AntwangXD/dds_hat/dds_article/dds_installed.png

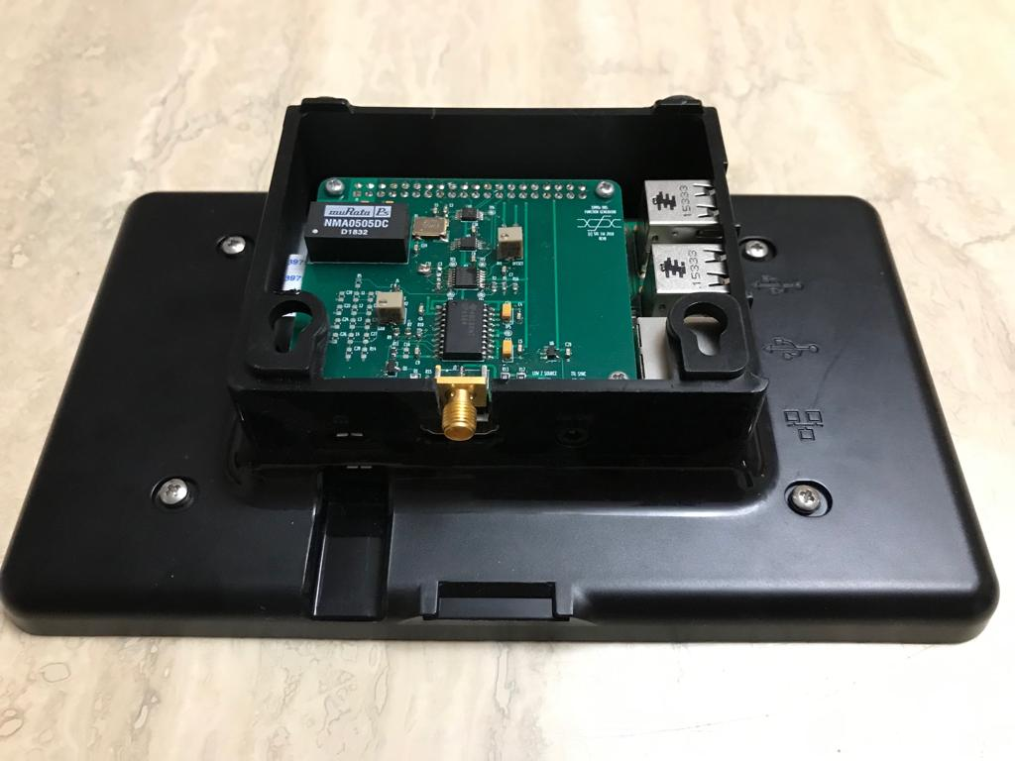
dds_article/dds_installed.png
