AntwangXD/dds_hat/dds_article/complete_instrument.png

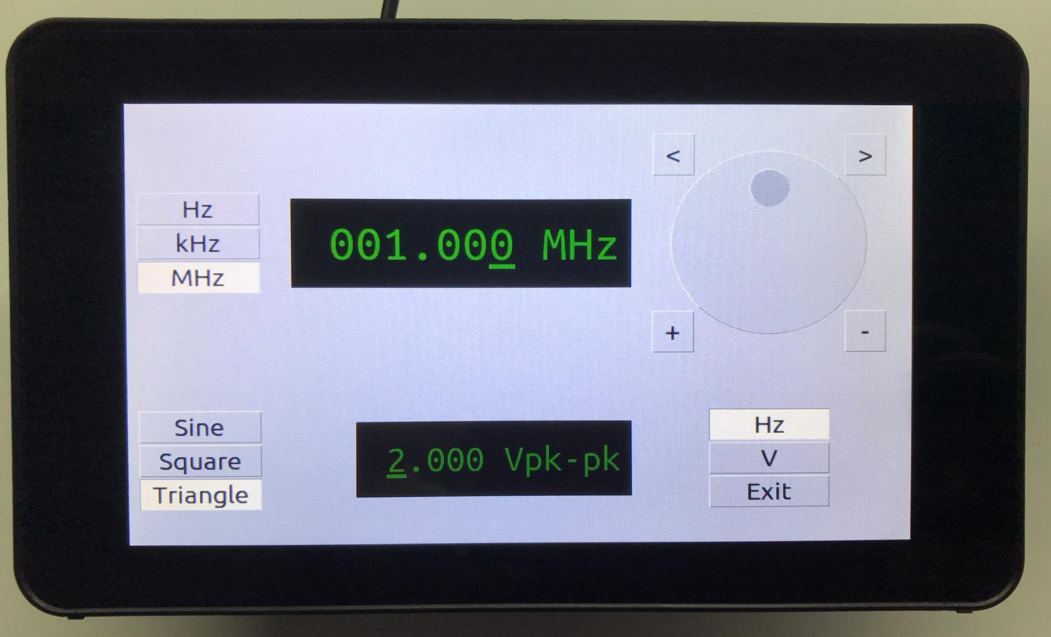
dds_article/complete_instrument.png
