AntwangXD/dds_hat/dds_article/LNM_Author_Contract_100-1.pdf

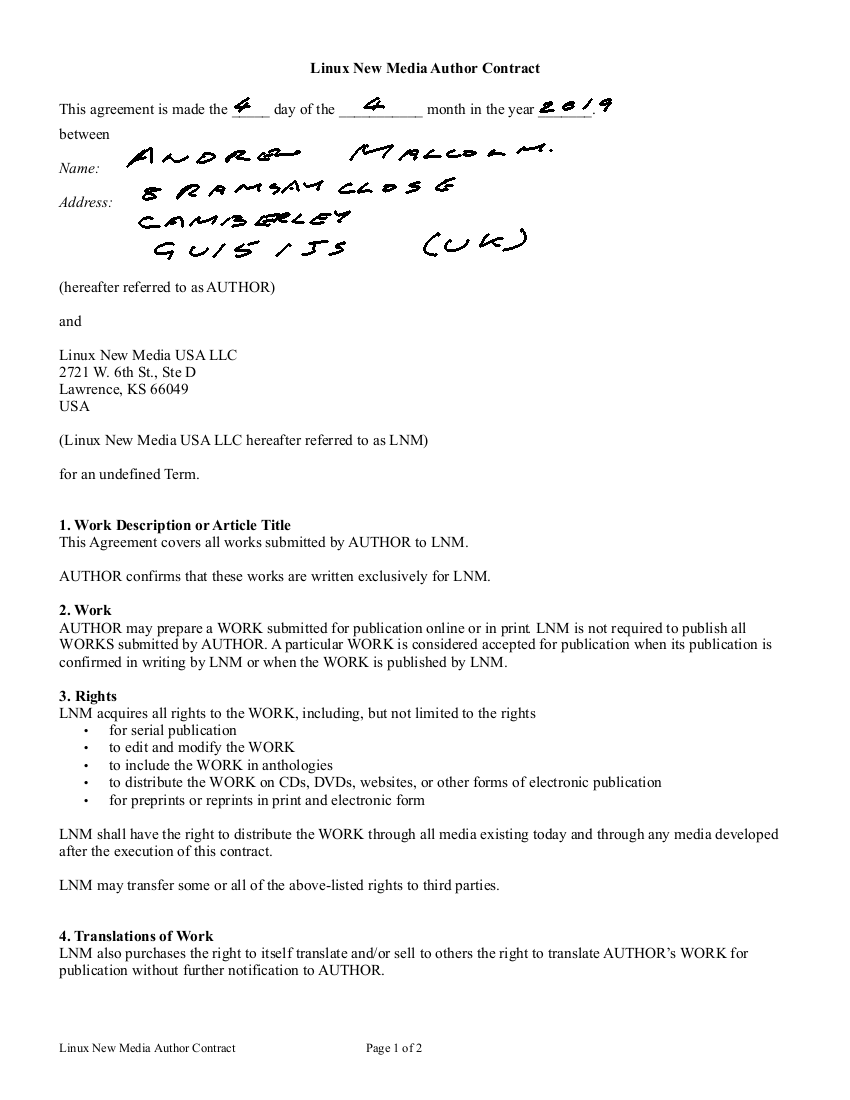
[picture p3: page 1]
