AntwangXD/dds_hat/dds_article/LNM_Author_Contract_100.pdf

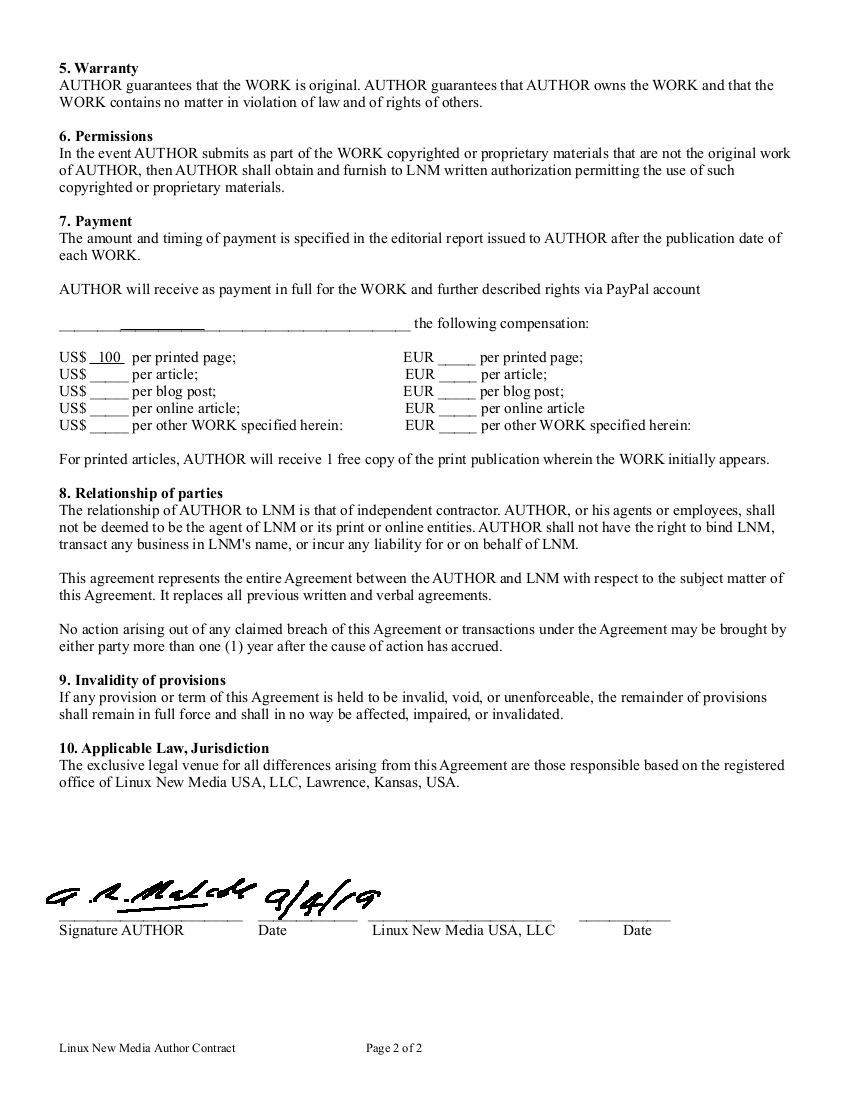
[picture p4: page 1]
