AntwangXD/dds_hat/dds_article/dds_gui.png

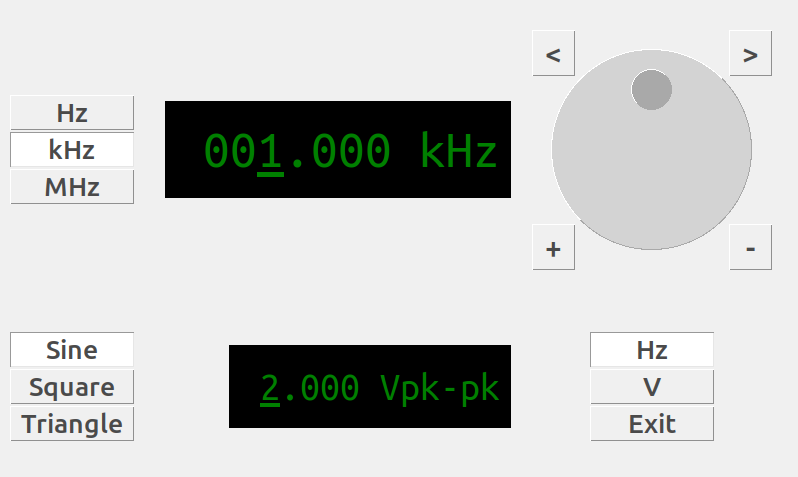
dds_article/dds_gui.png
