AntwangXD/dds_hat/dds_article/dds_render.png

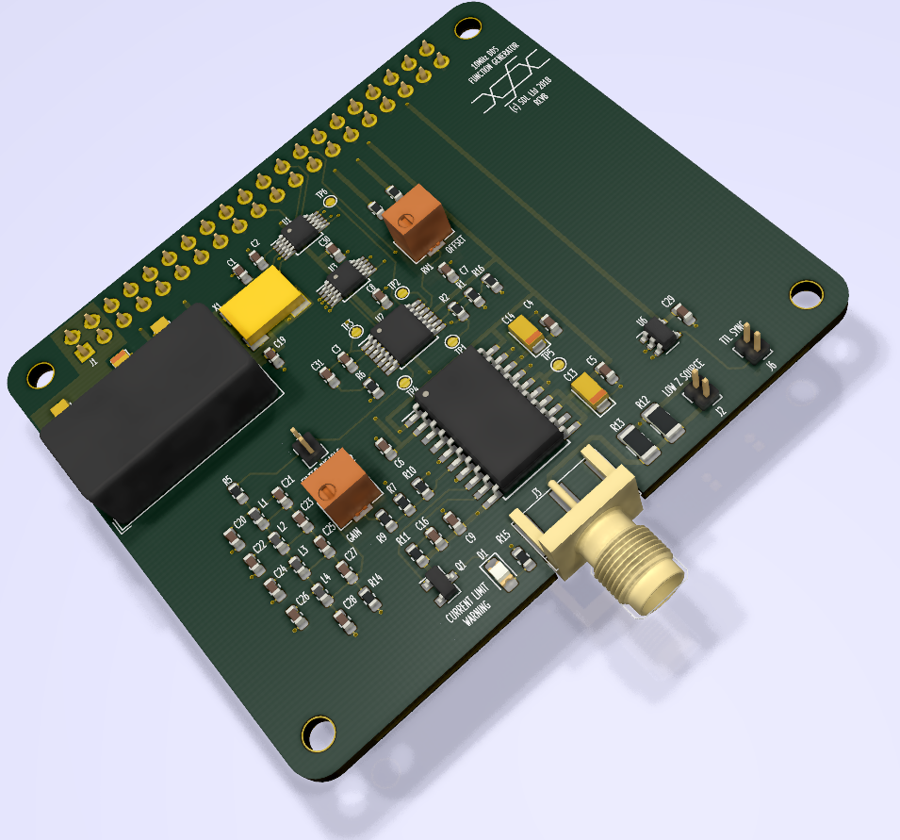
dds_article/dds_render.png
