AntwangXD/dds_hat/REVB/documents/filter-circuit.png

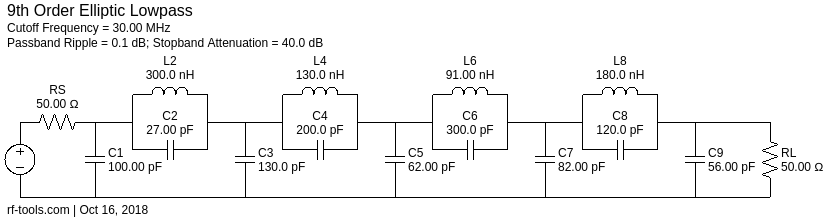
REVB/documents/filter-circuit.png
