AntwangXD/dds_hat/REVB/documents/filter-design.png

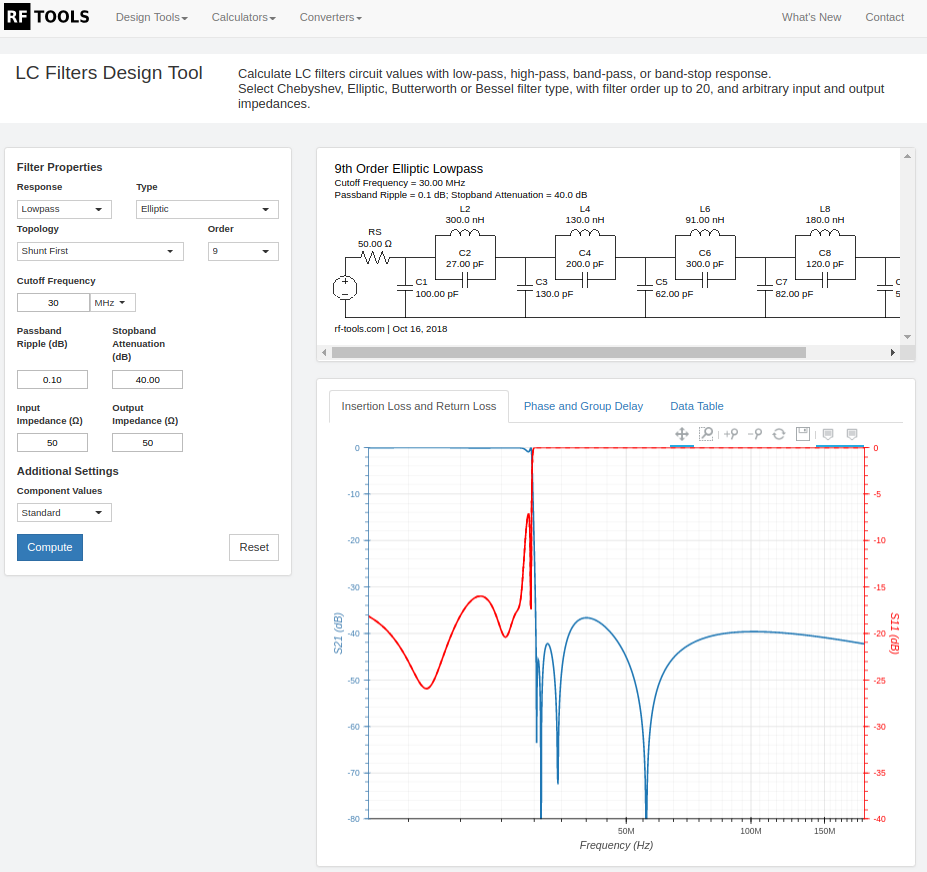
REVB/documents/filter-design.png
