AntwangXD/dds_hat/REVB/DDS-hat.ods

Id | Designator | Package | Quantity | Designation | Supplier and ref | Farnell p/n |  | Pack size
1 | J2,J5,J6 | PinHeader_1x02_P1.27mm_Vertical | 3 | Conn_01x02 |  |  |  |  | 0
2 | U4 | Converter_DCDC_muRata_NMAxxxxDC_THT | 1 | NMA0505DC |  | 1021427 | 6.86 |  | 6.86 | x | rs
3 | C31,C30,C29,C19,C10,C4,C5,C7,C8,C9,C11,C18,C6,C1 | C_0603_1608Metric | 14 | 100n |  |  |  |  | 0 | x
4 | J3 | SMA_EdgeMount | 1 | Cinch 142-0701-801 |  |  | 2.83 |  | 2.83 | x | stock
5 | U5 | HSOP-20_PowerPAD | 1 | OPA564AIDWP |  | 2782821 | 5.34 |  | 5.34 | x | post
6 | R16,R10,R7,R3,R4,R1 | R_0603_1608Metric | 6 | 1K |  |  |  |  | 0 | x
7 | U6 | TSOP-5_1.65x3.05mm_P0.95mm | 1 | 74AHC1G04GW5-7 |  | 1085239 | 0.16 | 5 | 0.16 | x | stock
8 | D1 | LED_LH_R974 | 1 | LH R974 |  | 1465992 | 0.21 |  | 0.21 | x
9 | Q1 | SOT-23 | 1 | BST82 |  | 1081313 | 0.1 |  | 0.1 | x | rs
10 | R15 | R_0603_1608Metric | 1 | 330R |  |  |  |  | 0 | x | rs
11 | C28 | C_0603_1608Metric | 1 | 56p |  |  |  |  | 0
12 | C27 | C_0603_1608Metric | 1 | 120p |  |  |  |  | 0
13 | C26,C24,C22 | C_0603_1608Metric | 3 | 75p |  |  |  |  | 0
14 | C25 | C_0603_1608Metric | 1 | 300p |  |  |  |  | 0
15 | C23 | C_0603_1608Metric | 1 | 200p |  |  |  |  | 0
16 | C21 | C_0603_1608Metric | 1 | 27p |  |  |  |  | 0
17 | C20 | C_0603_1608Metric | 1 | 100p |  |  |  |  | 0
18 | L3 | L_0603_1608Metric | 1 | 91n |  | 2448213 | 0.05 | 10 | 0.05
19 | L1 | L_0603_1608Metric | 1 | 330n |  | 2448216 | 0.09 | 10 | 0.09
20 | L4 | L_0603_1608Metric | 1 | 180n |  | 1457844 | 0.12 | 10 | 0.12
21 | L2 | L_0603_1608Metric | 1 | 120n |  | 2448215 | 0.06 | 10 | 0.06
22 | R5,R14 | R_0603_1608Metric | 2 | 50R |  |  |  |  | 0
23 | C14,C17,C15,C13,C12 | CP_EIA-3216-10_Kemet-I | 5 | 10u |  |  |  |  | 0
25 | RV2,RV1 | Potentiometer_Bourns_3214W_Vertical | 2 | 200R |  | 1612571 | 3.84 |  | 7.68 | x | existing
26 | X1 | MCSJK-6NC1-25.00-25-B | 1 | 25MHz |  | 2854377 | 0.66 |  | 0.66 | x | rs
27 | C16 | C_0603_1608Metric | 1 | 1n |  |  |  |  | 0 | x
28 | J1 | PinSocket_2x20_P2.54mm_Vertical | 1 | BCS-120-F-D-TE |  | 2308433 | 5.2 |  | 5.2 | x | sample
29 | U3 | MSOP-10_3x3mm_P0.5mm | 1 | AD5443YRMZ |  | 1581921 | 5.26 |  | 5.26 | x
30 | U2 | TSSOP-14_4.4x5mm_P0.65mm | 1 | OPA4354AIPW |  | 2112580 | 3.16 |  | 3.16
31 | R11,R6 | R_0603_1608Metric | 2 | 200K |  |  |  |  | 0
32 | R12,R13 | R_1206_3216Metric | 2 | 100R 400mW |  | 2008392 | 0.04 | 10 | 0.08 | x
33 | R9 | R_0603_1608Metric | 1 | 1K8 |  |  |  |  | 0
34 | R2 | R_0603_1608Metric | 1 | 6K8 |  |  |  |  | 0
35 | C3 | C_0603_1608Metric | 1 | 1p |  |  |  |  | 0
36 | C2 | C_0603_1608Metric | 1 | 10n |  |  |  |  | 0
37 | U1 | MSOP-10_3x3mm_P0.5mm | 1 | AD9833BRMZ |  | 1581966 | 7.4 |  | 7.4 |  | existing
 |  |  |  |  |  |  |  |  | 45.26
