AntwangXD/dds_hat/REVB/3214w-1-201e.stp

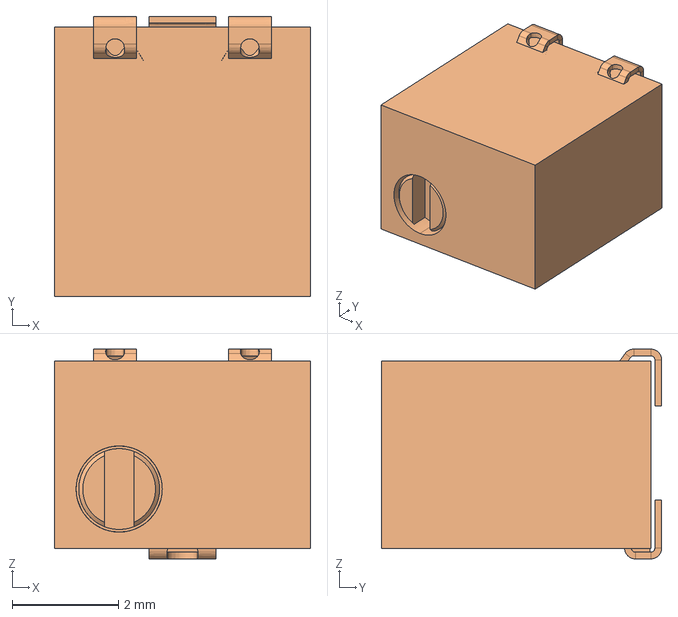
[picture p9: CAD file, 2019-06-15]
REVB/3214w-1-201e.stp
4.83 x 5.28 x 3.96 mm
