AntwangXD/dds_hat/REVB/3D models/SMD-XTAL.step

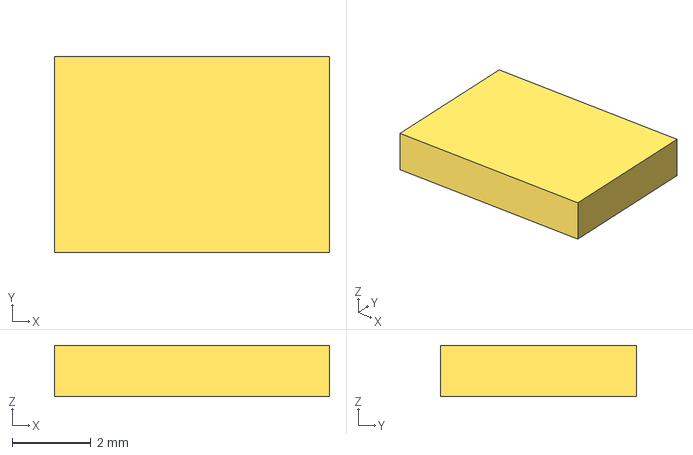
[picture p10: CAD file, 2019-06-15]
REVB/3D models/SMD-XTAL.step
7.00 x 5.00 x 1.30 mm
