AntwangXD/dds_hat/REVB/3D models/SMA-J-P-H-ST-EM1.stp

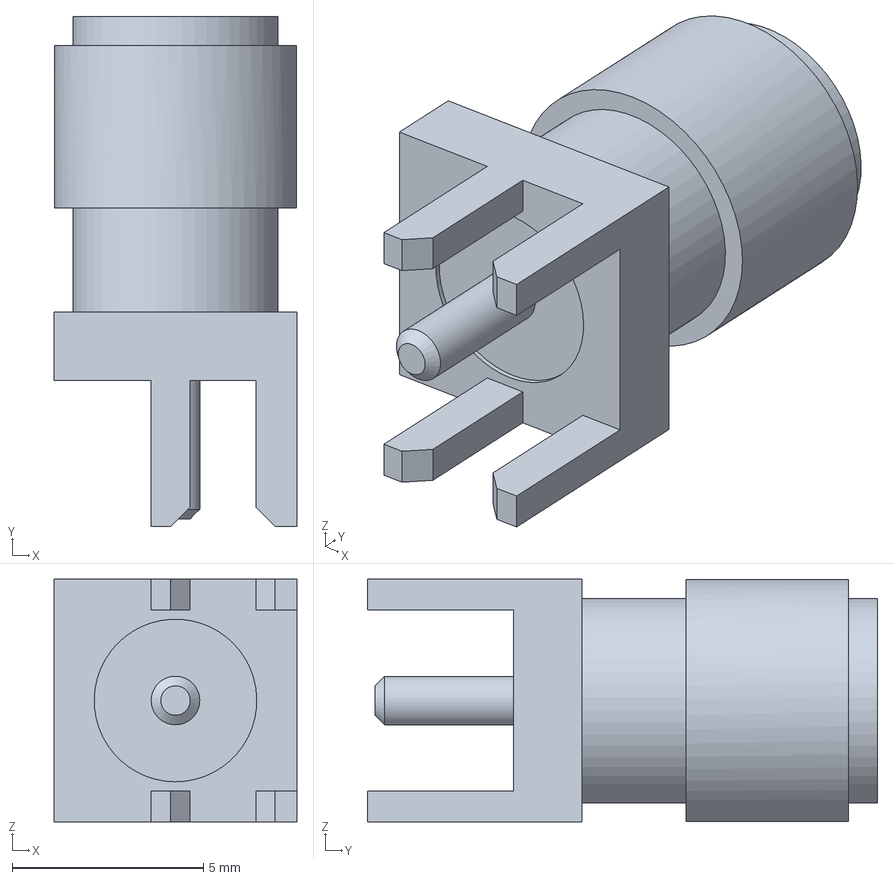
[picture p11: CAD file, 2019-06-15]
REVB/3D models/SMA-J-P-H-ST-EM1.stp
6.35 x 13.3 x 6.35 mm
