AntwangXD/dds_hat/REVB/3D models/142-0701-801.step

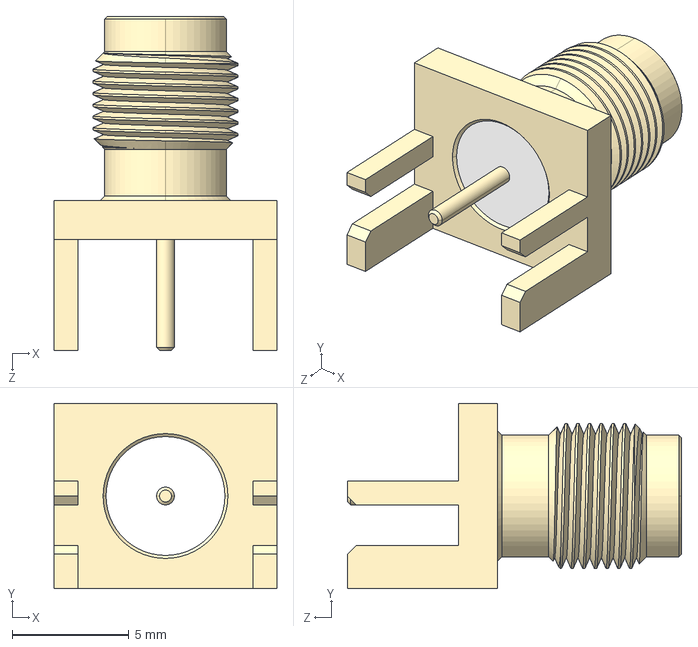
[picture p12: CAD file, 2019-06-15]
REVB/3D models/142-0701-801.step
9.52 x 7.92 x 14.3 mm
