AntwangXD/dds_hat/(list of files, cad)

Other CAD files:
REVA/3D models/SMD-XTAL.fcstd
REVB/3D models/SMD-XTAL.fcstd
