AntwangXD/dds_hat/dds_article/dds_schematic.pdf

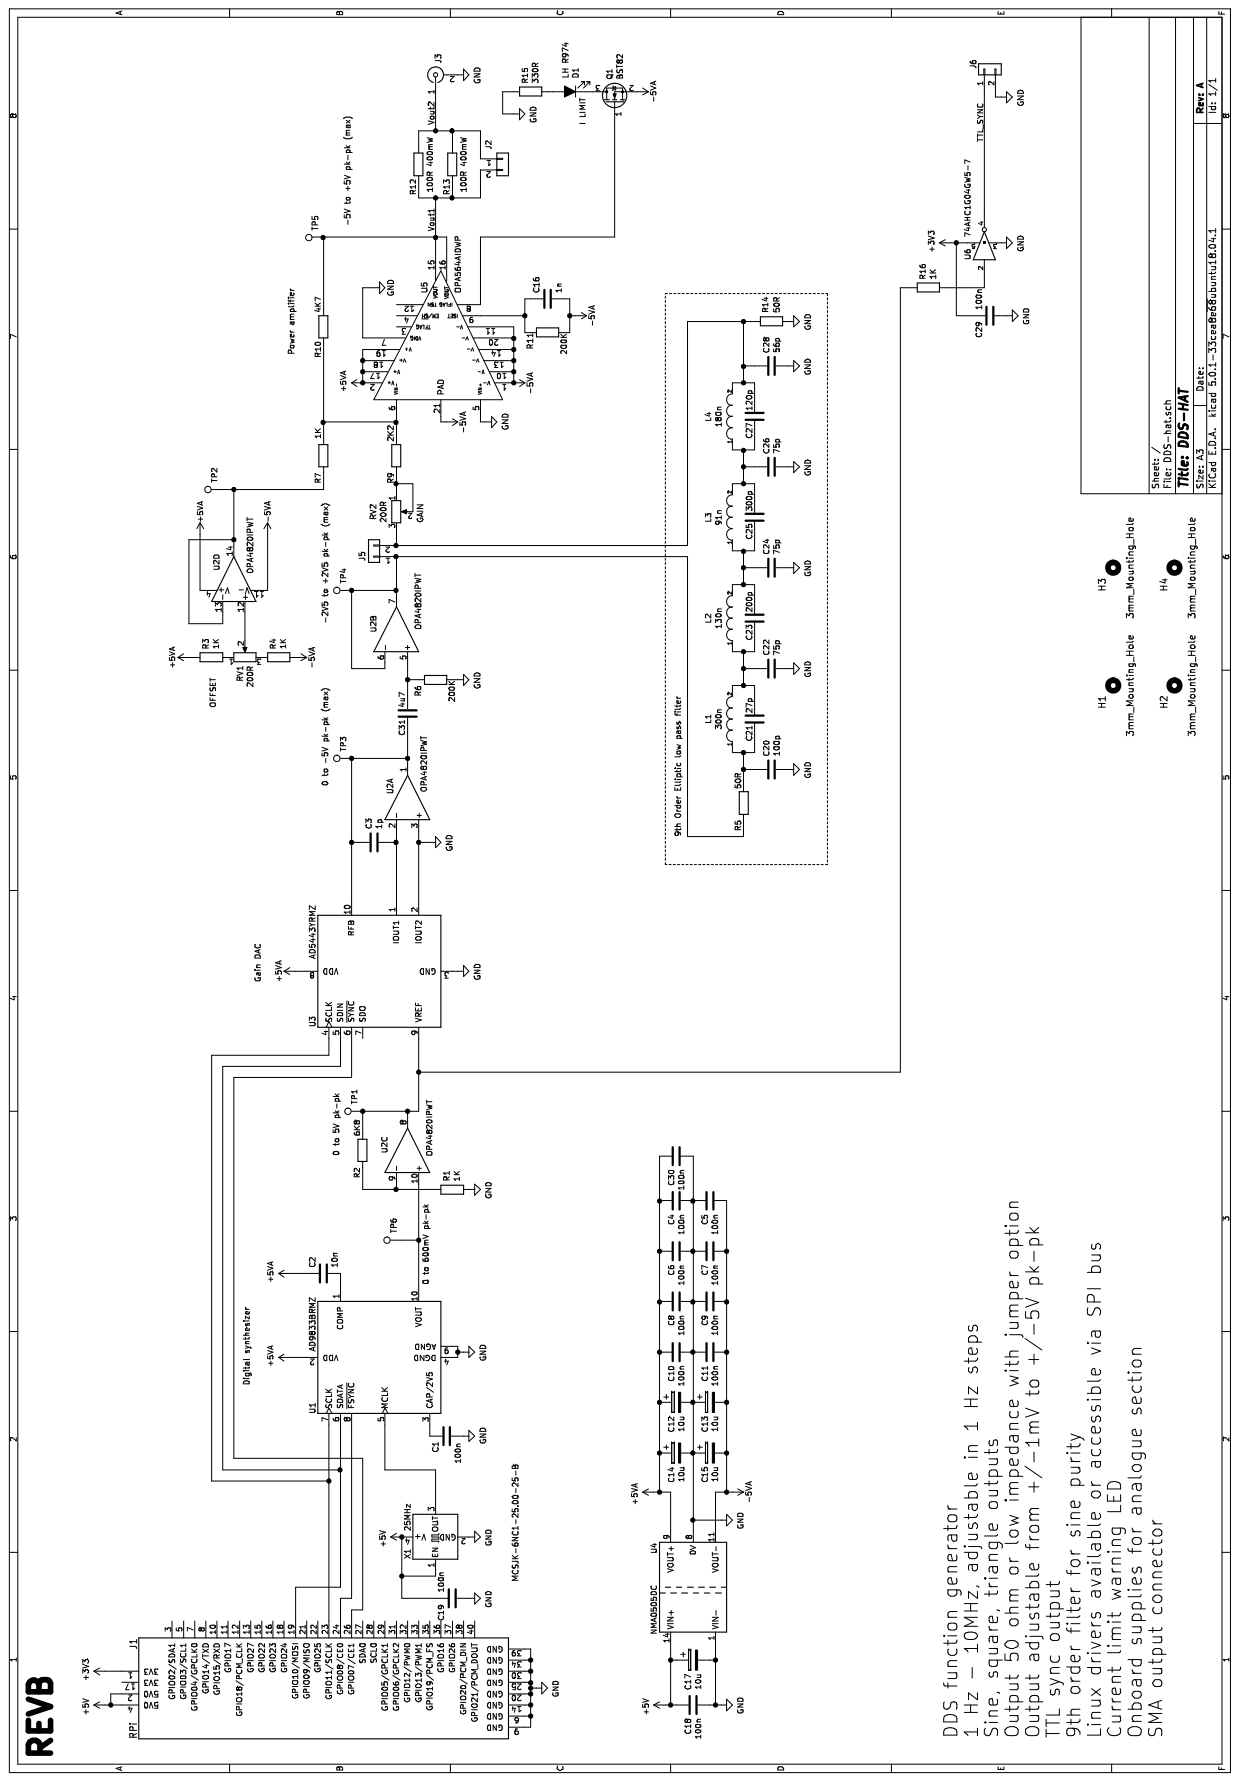
[picture p13: page 1]
