AntwangXD/dds_hat/REVB/DDS-hat.kicad_pcb

## KiCad design REVB/DDS-hat.kicad_pcb (2019-06-15)

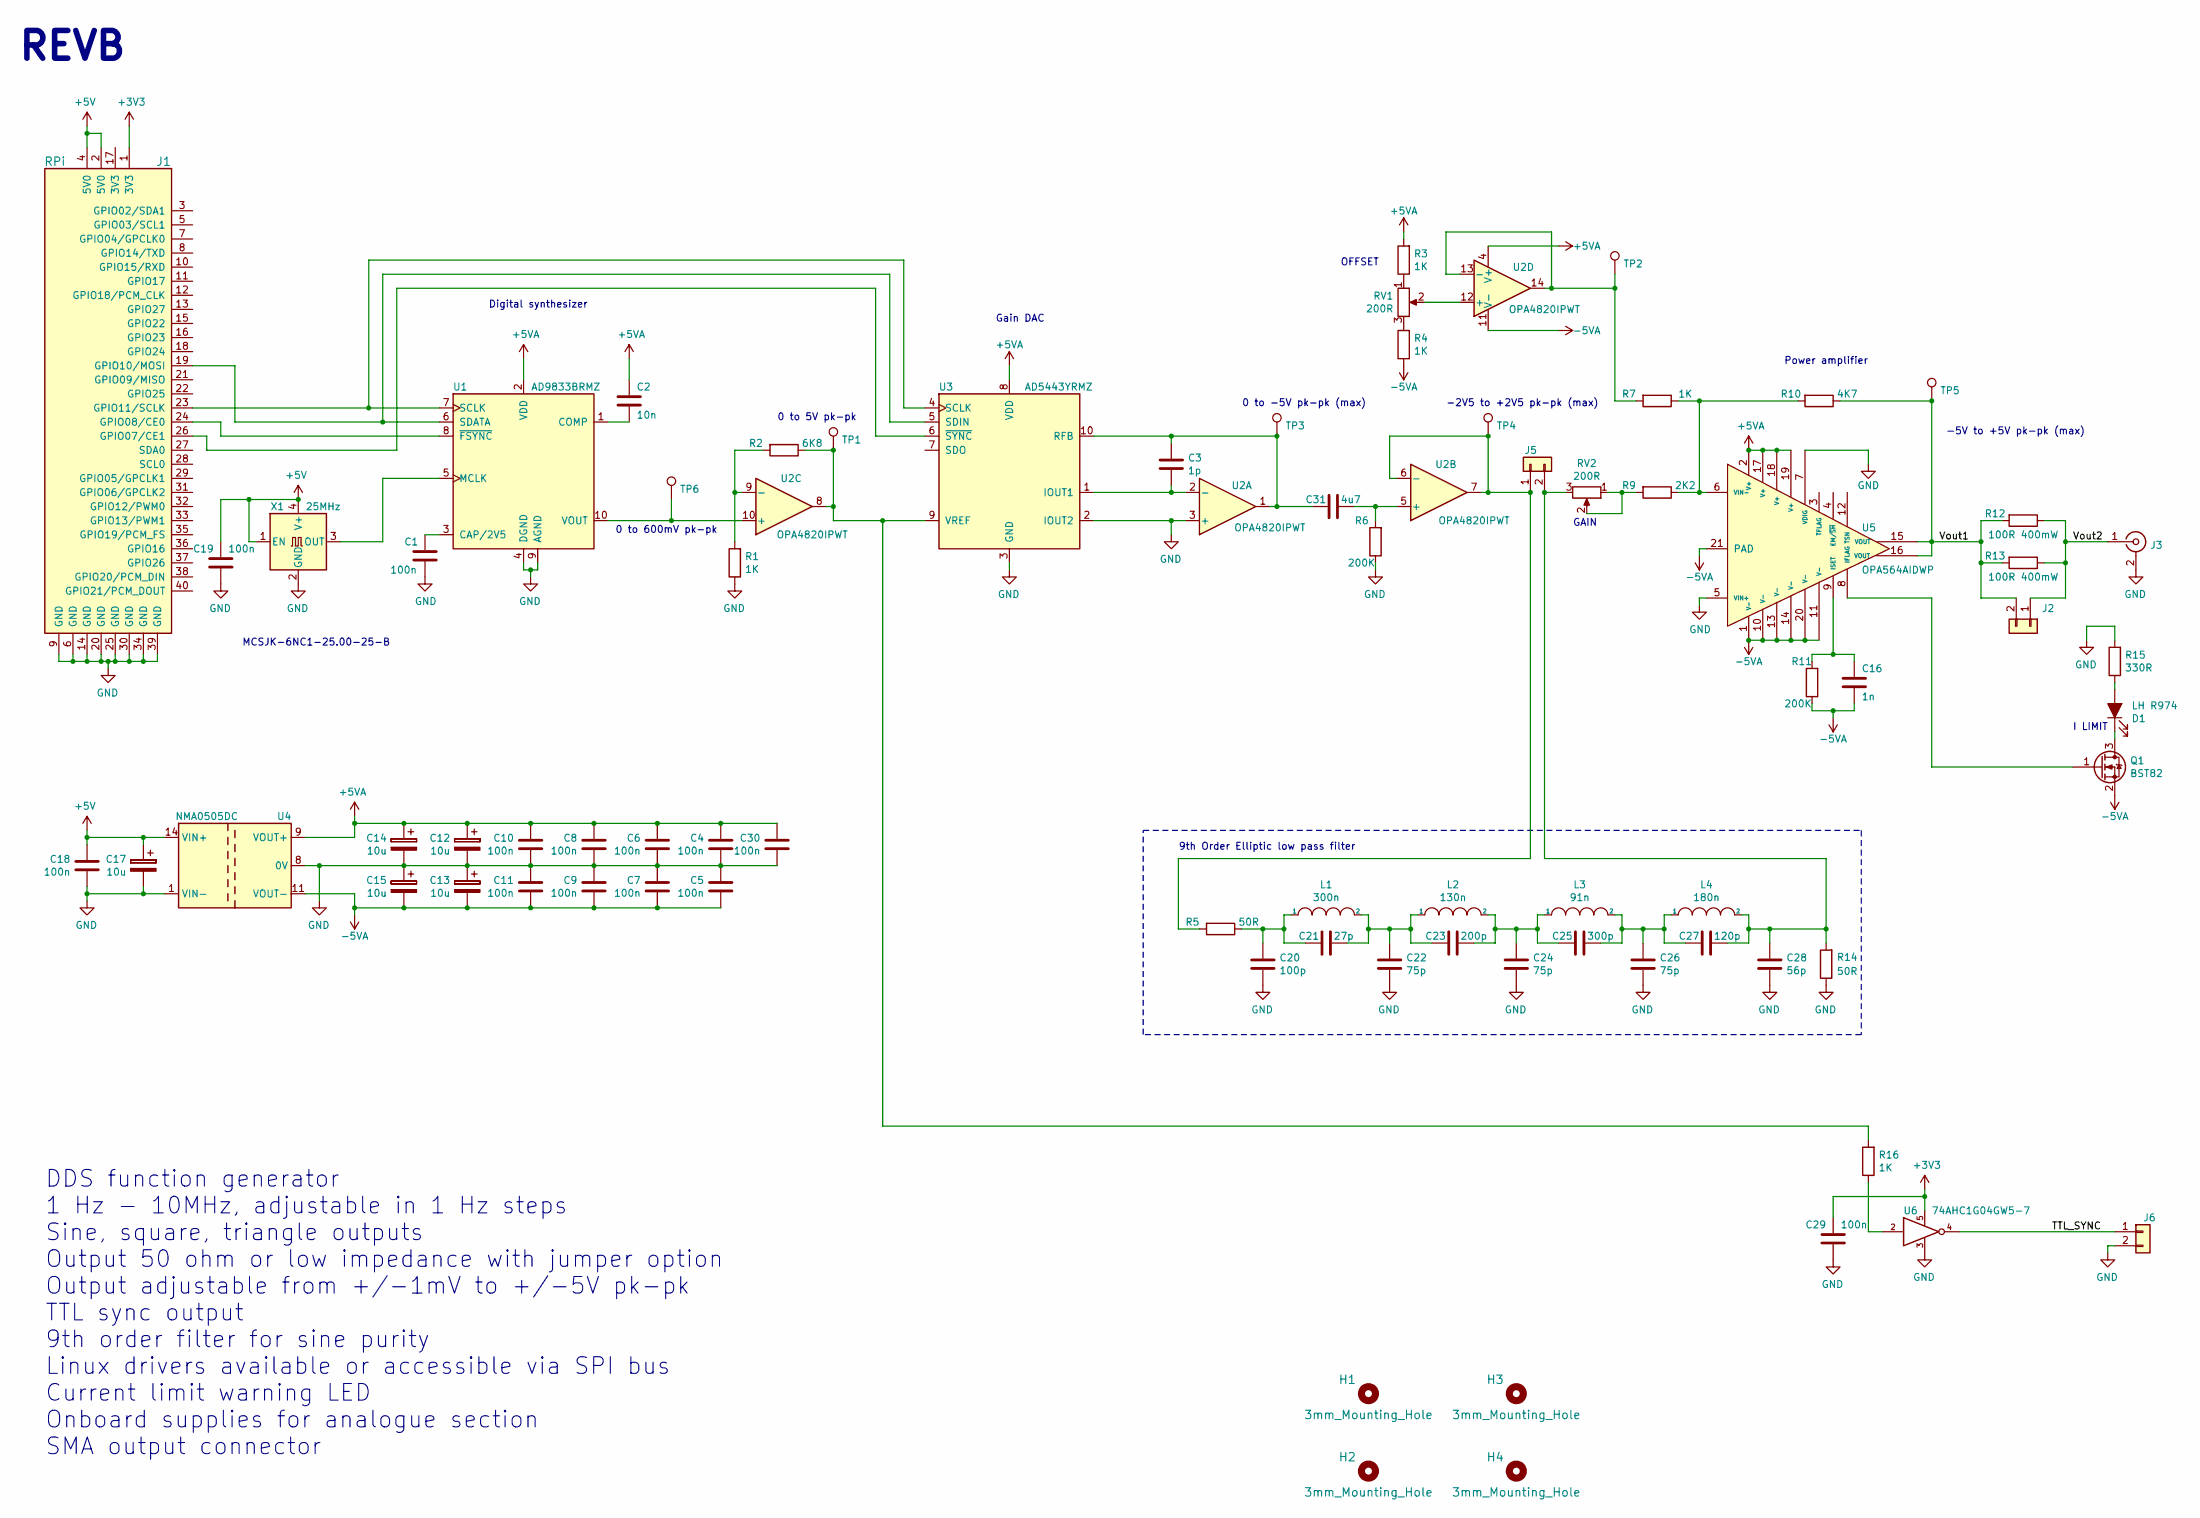
[picture p14: schematic DDS-hat.sch]

Parts:
C1, C4, C5, C6, C7, C8, C9, C10, C11, C18, C19, C29, C30: 100n; C_0603_1608Metric
C2: 10n; C_0603_1608Metric
C3: 1p; C_0603_1608Metric
C12, C13, C14, C15, C17: 10u; CP_EIA-3216-10_Kemet-I
C16: 1n; C_0603_1608Metric
C20: 100p; C_0603_1608Metric
C21: 27p; C_0603_1608Metric
C22, C24, C26: 75p; C_0603_1608Metric
C23: 200p; C_0603_1608Metric
C25: 300p; C_0603_1608Metric
C27: 120p; C_0603_1608Metric
C28: 56p; C_0603_1608Metric
C31: 4u7; C_0603_1608Metric
D1: LH R974; LED_LH_R974
H1, H2, H3, H4: 3mm_Mounting_Hole; NPTH_3mm_ID
J1: RPi; PinSocket_2x20_P2.54mm_Vertical
J2, J5, J6: Conn_01x02; PinHeader_1x02_P1.27mm_Vertical
J3: Cinch 142-0701-801; SMA_EdgeMount
L1: 300n; L_0603_1608Metric
L2: 130n; L_0603_1608Metric
L3: 91n; L_0603_1608Metric
L4: 180n; L_0603_1608Metric
Q1: BST82; SOT-23
R1, R3, R4, R7, R16: 1K; R_0603_1608Metric
R2: 6K8; R_0603_1608Metric
R5, R14: 50R; R_0603_1608Metric
R6, R11: 200K; R_0603_1608Metric
R9: 2K2; R_0603_1608Metric
R10: 4K7; R_0603_1608Metric
R12, R13: 100R 400mW; R_1206_3216Metric
R15: 330R; R_0603_1608Metric
RV1, RV2: 200R; Potentiometer_Bourns_3214W_Vertical
TP1, TP2, TP3, TP4, TP5, TP6: TestPoint; TestPoint_Pad_D1.0mm
U1: AD9833BRMZ; MSOP-10_3x3mm_P0.5mm
U2: OPA4820IPWT; TSSOP-14_4.4x5mm_P0.65mm
U3: AD5443YRMZ; MSOP-10_3x3mm_P0.5mm
U4: NMA0505DC; Converter_DCDC_muRata_NMAxxxxDC_THT
U5: OPA564AIDWP; HSOP-20_PowerPAD
U6: 74AHC1G04GW5-7; TSOP-5_1.65x3.05mm_P0.95mm
X1: 25MHz; S75005-50.000-X-15

Connections:
+3V3: C29.1, J1.1 (3V3), U6.5 (VCC)
+5V: C17.1, C18.1, C19.1, J1.2 (5V0), J1.4 (5V0), U4.14 (VIN+), X1.1 (EN), X1.4 (V+)
+5VA: C2.1, C4.1, C6.1, C8.1, C10.1, C12.1, C14.1, C30.1, R3.2, U1.2 (VDD), U2.4 (V+), U3.8 (VDD), U4.9 (VOUT+), U5.2 (V+), U5.17 (V+), U5.18 (V+), U5.19 (V+)
-5VA: C5.2, C7.2, C9.2, C11.2, C13.2, C15.2, C16.2, Q1.2 (S), R4.1, R11.1, U2.11 (V-), U4.11 (VOUT-), U5.1 (V-), U5.10 (V-), U5.11 (V-), U5.13 (V-), U5.14 (V-), U5.20 (V-), U5.21 (PAD)
/TTL_SYNC: J6.1, U6.4
/Vout1: J2.2, R10.1, R12.2, R13.2, TP5.1, U5.15 (VOUT), U5.16 (VOUT)
/Vout2: J2.1, J3.1 (In), R12.1, R13.1
GND: C1.2, C4.2, C5.1, C6.2, C7.1, C8.2, C9.1, C10.2, C11.1, C12.2, C13.1, C14.2, C15.1, C17.2, C18.2, C19.2, C20.2, C22.2, C24.2, C26.2, C28.2, C29.2, C30.2, J1.6 (GND), J1.9 (GND), J1.14 (GND), J1.20 (GND), J1.25 (GND), J1.30 (GND), J1.34 (GND), J1.39 (GND), J3.2 (Ext), J6.2, R1.1, R6.1, R14.1, R15.2, U1.4 (DGND), U1.9 (AGND), U2.3 (+), U3.2 (IOUT2), U3.3 (GND), U4.1 (VIN-), U4.8 (0V), U5.5 (VIN+), U5.7 (VDIG), U6.3 (GND), X1.2 (GND)
unnamed: C1.1, U1.3 (CAP/2V5)
unnamed: C2.2, U1.1 (COMP)
unnamed: C3.1, C31.2, TP3.1, U2.1, U3.10 (RFB)
unnamed: C3.2, U2.2 (-), U3.1 (IOUT1)
unnamed: C16.1, R11.2, U5.9 (ISET)
unnamed: C20.1, C21.2, L1.1, R5.1
unnamed: C21.1, C22.1, C23.2, L1.2, L2.1
unnamed: C23.1, C24.1, C25.2, L2.2, L3.1
unnamed: C25.1, C26.1, C27.2, L3.2, L4.1
unnamed: C27.1, C28.1, J5.2, L4.2, R14.2, RV2.3
unnamed: C31.1, R6.2, U2.5 (+)
unnamed: D1.1 (K), Q1.3 (D)
unnamed: D1.2 (A), R15.1
unnamed: J1.19 (GPIO10/MOSI), U1.6 (SDATA), U3.5 (SDIN)
unnamed: J1.23 (GPIO11/SCLK), U1.7 (SCLK), U3.4 (SCLK)
unnamed: J1.24 (GPIO08/CE0), U1.8 (~FSYNC)
unnamed: J1.26 (GPIO07/CE1), U3.6 (~SYNC)
unnamed: J5.1, R5.2, TP4.1, U2.6 (-), U2.7
unnamed: Q1.1 (G), U5.8 (IFLAG)
unnamed: R1.2, R2.2, U2.9 (-)
unnamed: R3.1, RV1.1
unnamed: R4.2, RV1.3
unnamed: R7.2, TP2.1, U2.13 (-), U2.14
unnamed: R9.2, RV2.1, RV2.2
unnamed: R7.1, R9.1, R10.2, U5.6 (VIN-)
unnamed: R16.1, U6.2
unnamed: R2.1, R16.2, TP1.1, U2.8, U3.9 (VREF)
unnamed: RV1.2, U2.12 (+)
unnamed: TP6.1, U1.10 (VOUT), U2.10 (+)
unnamed: U1.5 (MCLK), X1.3 (OUT)

Notes on the sheet:
REVB
0 to 600mV pk-pk
0 to 5V pk-pk
0 to -5V pk-pk (max)
-2V5 to +2V5 pk-pk (max)
OFFSET
GAIN
9th Order Elliptic low pass filter
I LIMIT
-5V to +5V pk-pk (max)
DDS function generator 1 Hz - 10MHz, adjustable in 1 Hz steps Sine, square, triangle outputs Output 50 ohm or low impedance with jumper option Output adjustable from +/-1mV to +/-5V pk-pk TTL sync output 9th order filter for sine purity Linux drivers available or accessible via SPI bus Current limi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
MCSJK-6NC1-25.00-25-B
Digital synthesizer
Gain DAC
Power amplifier

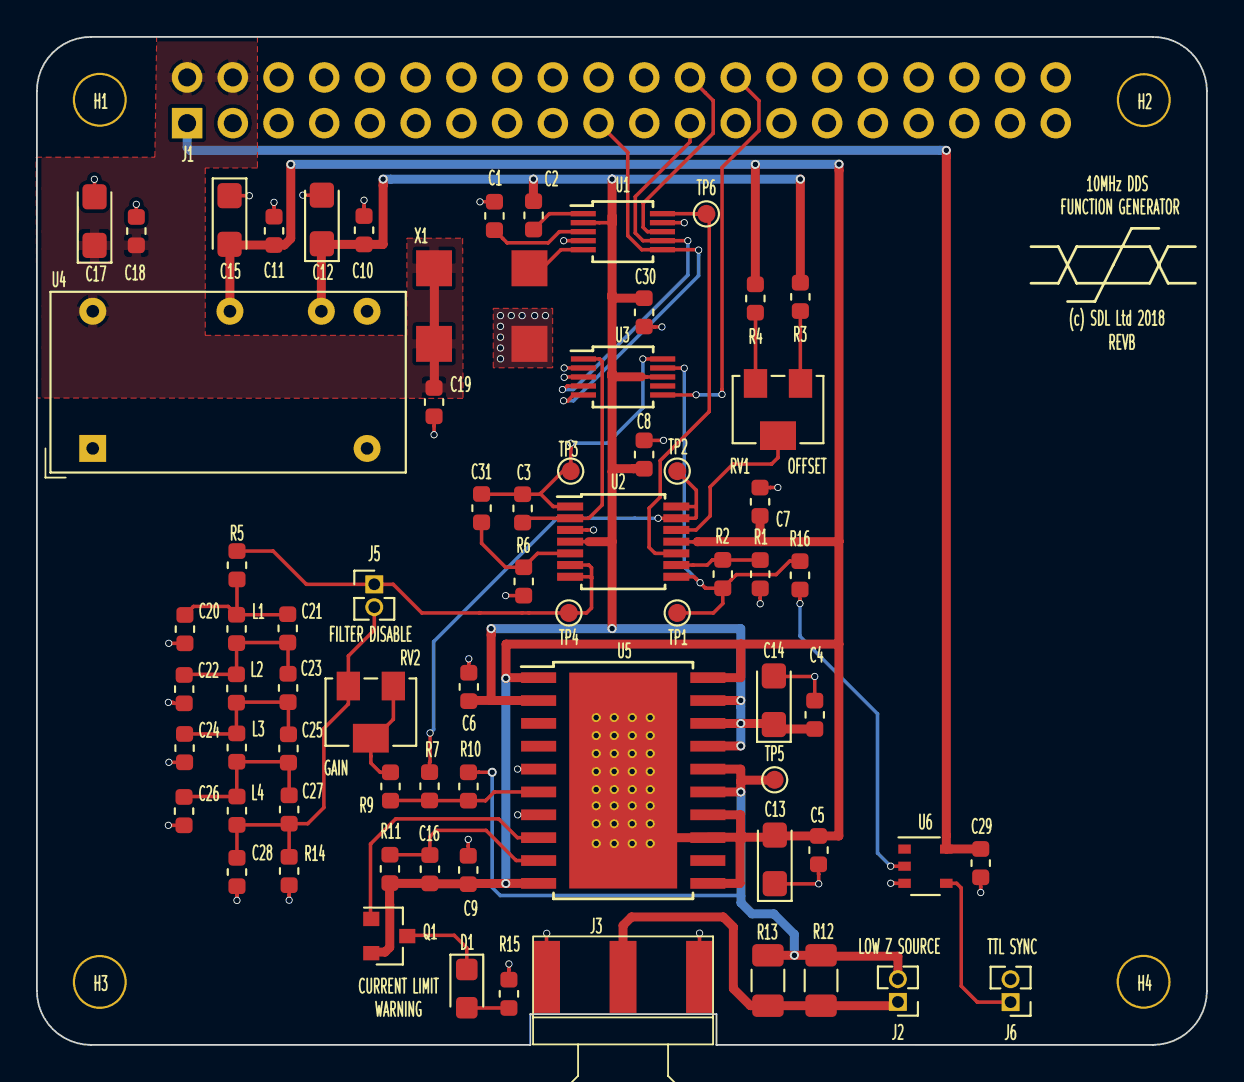
[picture p15: board DDS-hat.kicad_pcb from above]

Board: 2 copper layers, 65.0 x 56.0 mm, 77 parts (1 on the bottom side), 38 nets.

Other parts of the board:
(c) SDL Ltd 2018: SDL Logo
