AntwangXD/dds_hat/dds_driver/ad9834.mod.c

#include <linux/module.h>
#include <linux/vermagic.h>
#include <linux/compiler.h>

MODULE_INFO(vermagic, VERMAGIC_STRING);
MODULE_INFO(name, KBUILD_MODNAME);

__visible struct module __this_module
__attribute__((section(".gnu.linkonce.this_module"))) = {
	.name = KBUILD_MODNAME,
	.init = init_module,
#ifdef CONFIG_MODULE_UNLOAD
	.exit = cleanup_module,
#endif
	.arch = MODULE_ARCH_INIT,
};

#ifdef RETPOLINE
MODULE_INFO(retpoline, "Y");
#endif

static const char __module_depends[]
__used
__attribute__((section(".modinfo"))) =
"depends=industrialio";

MODULE_ALIAS("spi:ad9833");
MODULE_ALIAS("spi:ad9834");
MODULE_ALIAS("spi:ad9837");
MODULE_ALIAS("spi:ad9838");
